RobotechyShop/robodash/3d-model/Bezel.dxf

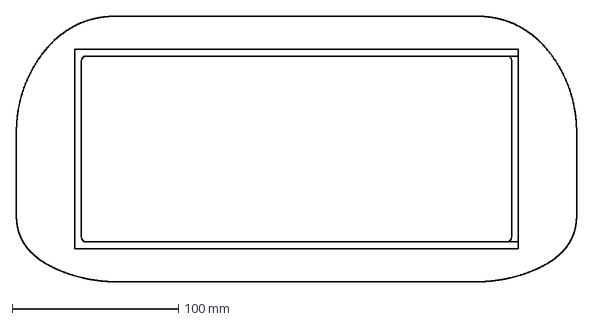
[picture p2: CAD file, 2026-02-10]
3d-model/Bezel.dxf
337.4 x 159.9 mm
