RobotechyShop/robodash/3d-model/Robodash Right Bottom.stl

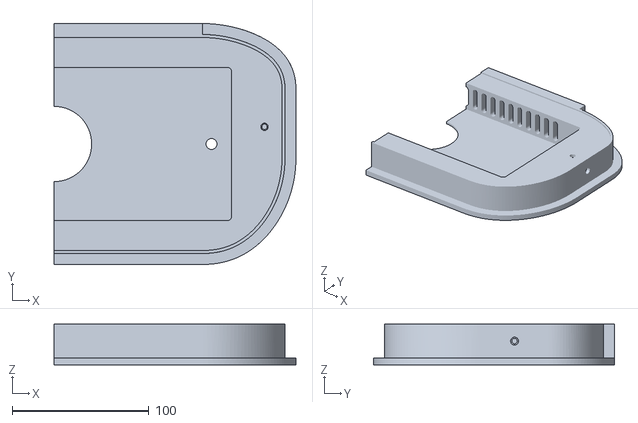
[picture p3: CAD file, 2025-12-07]
3d-model/Robodash Right Bottom.stl
176.7 x 175.9 x 29.8
