RobotechyShop/robodash/3d-model/Robodash Left Bottom.stl

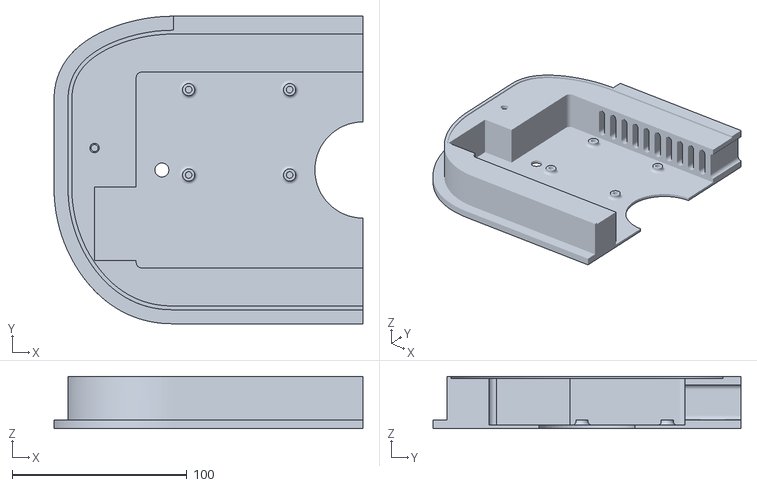
[picture p4: CAD file, 2025-12-07]
3d-model/Robodash Left Bottom.stl
176.7 x 175.9 x 29.8
