RobotechyShop/robodash/3d-model/Robodash Top.3mf

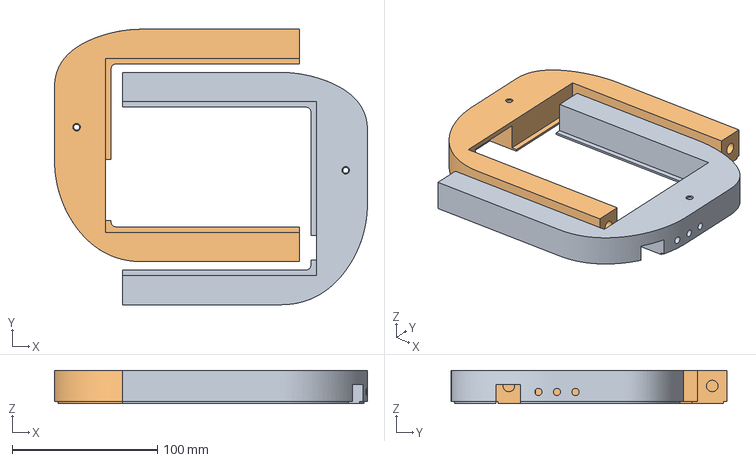
[picture p5: CAD file, 2025-12-03]
3d-model/Robodash Top.3mf
215.3 x 189.6 x 22.8 mm
Robodash Right Top.stl
Robodash Left Top.stl
