RobotechyShop/robodash/3d-model/Robodash Left Top.stl

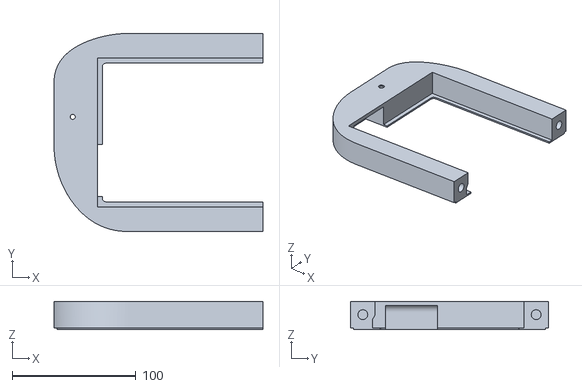
[picture p6: CAD file, 2025-12-03]
3d-model/Robodash Left Top.stl
168.7 x 159.9 x 22.8
