RobotechyShop/robodash/3d-model/Robodash Single Bezel.stl

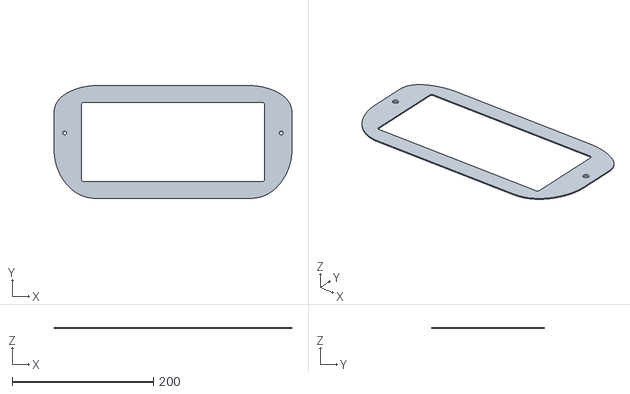
[picture p7: CAD file, 2025-12-03]
3d-model/Robodash Single Bezel.stl
337.4 x 159.9 x 1.40
