RobotechyShop/robodash/3d-model/Robodash Left Bezel.stl

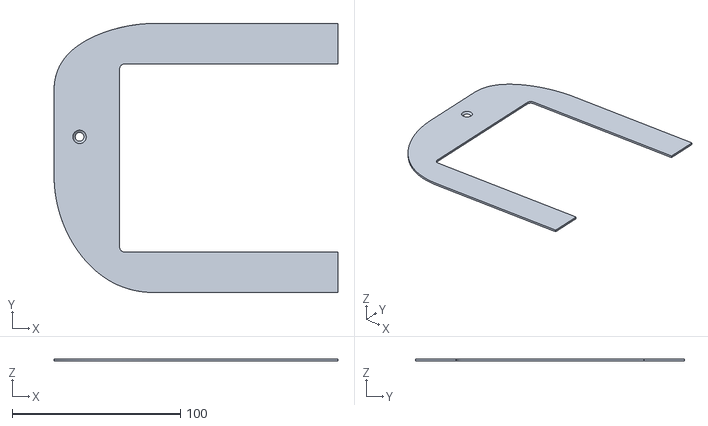
[picture p8: CAD file, 2025-12-03]
3d-model/Robodash Left Bezel.stl
168.7 x 159.9 x 1.40
