RobotechyShop/robodash/3d-model/Sun Block Right.stl

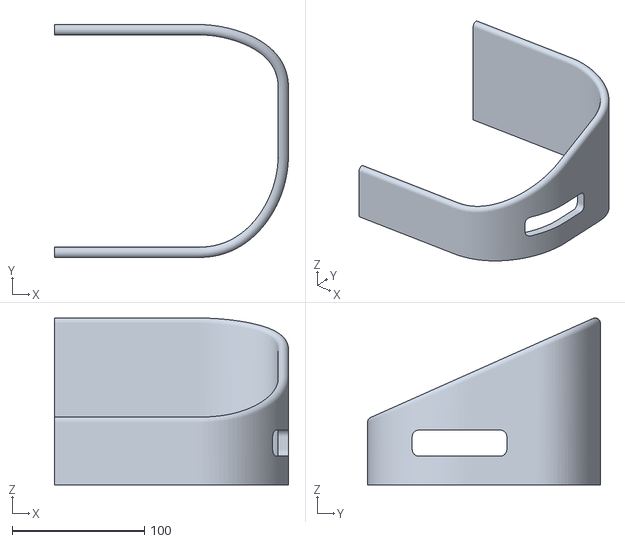
[picture p9: CAD file, 2025-12-03]
3d-model/Sun Block Right.stl
176.7 x 175.9 x 126.1
