RobotechyShop/robodash/3d-model/Sun Block Left.stl

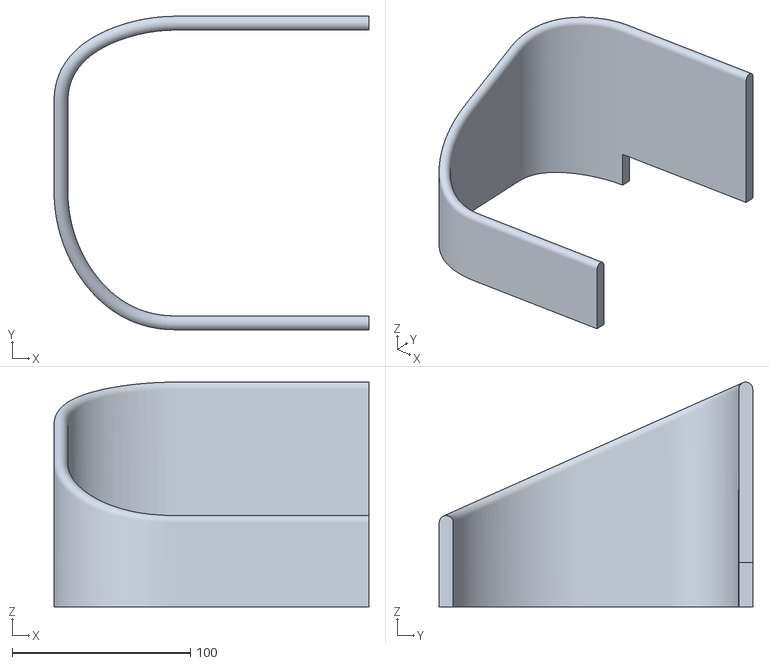
[picture p10: CAD file, 2025-12-03]
3d-model/Sun Block Left.stl
176.7 x 175.9 x 126.1
