RobotechyShop/robodash/3d-model/Screen.stl

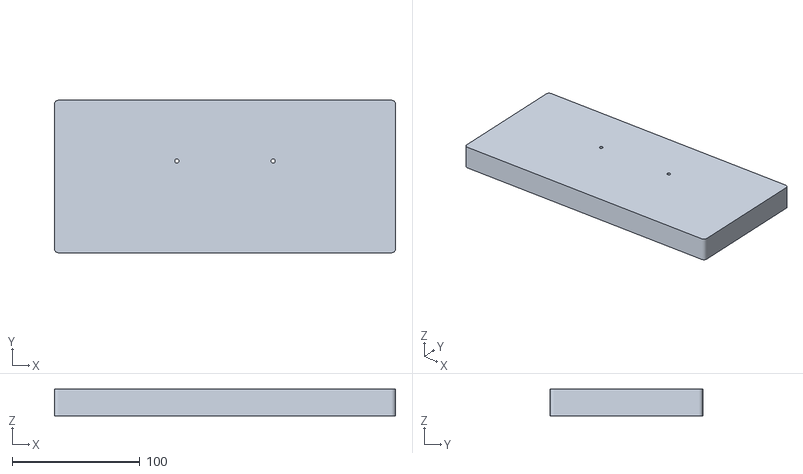
[picture p12: CAD file, 2025-12-02]
3d-model/Screen.stl
267.0 x 119.5 x 20.9
