RobotechyShop/robodash/(list of files, cad)

Other CAD files:
3d-model/Robodash Right Bezel.stl
3d-model/Robodash.f3d
