RobotechyShop/robodash/(commit log)

2025-10-30 Update README with project details, remove personal info and unnecessary sections
    [robodash.f3d]
2025-10-30 Add exported STL files from 3D model
    [Robodash Left Bottom.stl, Robodash Left Top.stl, Robodash Right Bottom.stl, Robodash Right Top.stl]
2025-12-02 Updated STLs
    [Robodash Left Bottom (1).stl, Robodash Left Bottom.stl, Robodash Left Top.stl, Robodash Right Bottom (1).stl, Robodash Right Bottom.stl, Robodash Right Top.stl, Robodash.stl, Screen.stl]
2025-12-03 Updated with single bezel piece and minor modifications
    [Robodash Left Bezel.stl, Robodash Left Bottom.stl, Robodash Left Top.stl, Robodash Right Bezel.stl, Robodash Right Bottom.stl, Robodash Right Top.stl, Sun Block (Left).stl, Sun Block (Right).stl]
2025-12-03 Added Fusion 360 3mf file
    [Robodash.3mf, Robodash.stl]
2025-12-03 Added single bezel, renamed some files
    [Robodash Left Bottom (1).stl, Robodash Right Bottom (1).stl, Robodash Single Bezel.stl, Sun Block Left.stl, Sun Block Right.stl]
2025-12-03 Removed bottom bezel near cables
    [Robodash Left Top.stl]
2025-12-03 Original Fusion files and modified supports
    [Robodash Top.3mf, Robodash.3mf, Robodash.f3d]
2025-12-07 Mounts and vents added
    [Robodash Left Bottom.stl, Robodash Right Bottom.stl]
2026-01-05 Add dashboard software implementation
    - PyQt5-based racing dashboard with real-time telemetry display
    - Mock data source for development (synthesized engine sound)
    - CAN bus integration for ECUMaster EMU Black ECU
    - Race layout with gear, speed, RPM bar, and metric displays
    - Robotechy dark theme with luminous green accent
    - Multi-display support (auto-positions on secondary screen)
    - FuelBar widget with configurable warning thresholds
    - Test suite and CI workflow
    Reference: https://github.com/valtsu23/DIY-Emu-Black-Dash
2026-01-05 Improve dashboard layout for 720p display
    - Fix label cutoffs (GEAR, Speed, mph properly positioned)
    - Widen left panel (280px) and right panel (600px)
    - Make speed display much larger (0.8 font ratio)
    - Double RPM bar height (250px minimum)
    - Add visual FuelBar widget with sliding fill
    - Right-align values in MetricBox
    - Move Connected status under Gear/Boost
    - Remove bottom warning indicators
2026-01-05 Add Japanese Robot font and improve UI visibility
    - Download and configure Japanese Robot font for futuristic styling
    - Make speed display text white for maximum visibility
    - Fix fuel gauge percentage display (widen value area to fit "100%")
    - Update splash screen to use custom font for "R" logo
    - Move boost gauge to right panel next to battery
    - Mock fuel starts at 33%, declines, restarts when empty
    [mock_source.py]
2026-01-05 Improve dashboard readability and visual polish
    - Add shadow effect to splash screen R logo
    - Fix RPM markers positioning with reserved space at bottom
    - Redesign fuel gauge with centered percentage overlay (white text)
    - Increase value smoothing for easier reading (speed alpha 0.05, rpm 0.08)
    - Move mph label directly under speed value
    - Start mock fuel at 29%
    - Increase RPM bar height for better visibility
    - Larger RPM display digits
    [mock_source.py]
2026-01-06 Fix linter issues (black, isort, flake8)
    - Format all files with black
    - Fix import ordering with isort
    - Remove unused imports
    - Add noqa comments for intentional re-exports in __init__.py files
    - Move TYPE_CHECKING imports to top of files
    - Fix f-string without placeholder
    [base.py, can_source.py]
