RobotechyShop/robodash/(notices)

Notices in the files:
README.md:
License: Educational
